heeseopark7/PROJECT4/proj4_make/TOP/5_PNR/snap/0_floorplan.png

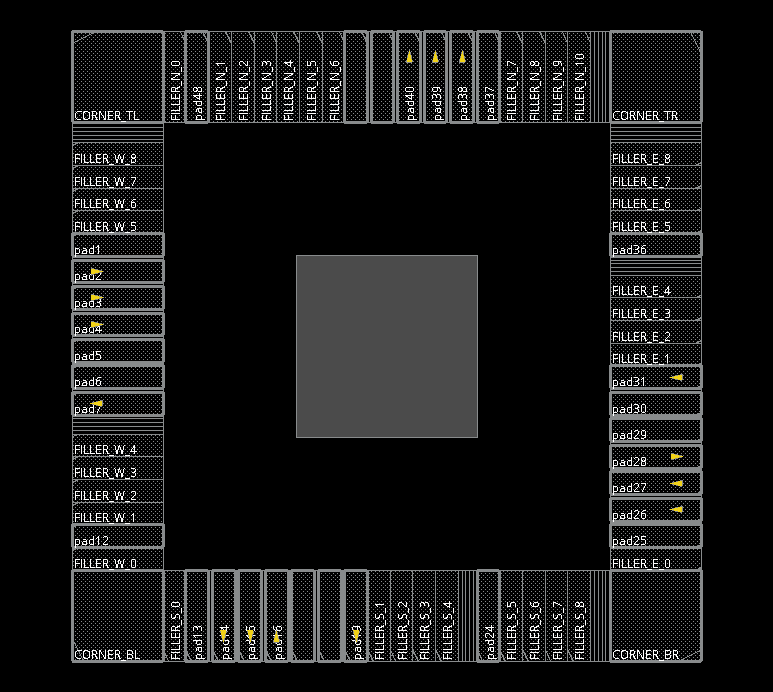
proj4_make/TOP/5_PNR/snap/0_floorplan.png
