heeseopark7/PROJECT4/proj4_make/TOP/5_PNR/result.txt

###############################################################
#  Generated by:      Cadence Innovus 22.17-s086_1
#  OS:                Linux x86_64(Host ID kopo-seongnam)
#  Generated on:      Mon Nov  9 23:03:33 2026
#  Design:            mcu_pad_top
#  Command:           checkFPlan -outFile result.txt
###############################################################
WARNING (IMPFP-7236): DIE's corner: (1370.0000000000 , 1370.0000000000) is NOT on PlacementGrid,  Please use command getFPlanMode to check current Grid settings, use command setFPlanMode to change which grid to snap to. And use command get_snap_grid_info to get grids' offset and pitch. Command floorplan can be used to fix this issue.
INFO (IMPFP-7241): Tech site CoreSite has no symmetry Y. 	Current symmetry setting : isSymmetryR90 false; isSymmetryX : false; isSymmetryY : false;

INFO (IMPFP-7244): Area Io : pad5 NOT overlapped with any rows.
INFO (IMPFP-7244): Area Io : pad6 NOT overlapped with any rows.
INFO (IMPFP-7244): Area Io : pad17 NOT overlapped with any rows.
INFO (IMPFP-7244): Area Io : pad18 NOT overlapped with any rows.
INFO (IMPFP-7244): Area Io : pad29 NOT overlapped with any rows.
INFO (IMPFP-7244): Area Io : pad30 NOT overlapped with any rows.
INFO (IMPFP-7244): Area Io : pad41 NOT overlapped with any rows.
INFO (IMPFP-7244): Area Io : pad42 NOT overlapped with any rows.
**INFO: No. of regular pre-routes not on tracks : 0
