heeseopark7/PROJECT4/(list of files, drawings)

Other design files:
proj4_make/TOP/2_SIM/FUNCTION/dump/tb_mcu_top/tb_mcu_top.dsn
proj4_make/TOP/2_SIM/FUNCTION/waves.shm/waves.dsn
proj4_make/TOP/2_SIM/POST/max/dump/tb_mcu_top_sdf_post_wst/tb_mcu_top_sdf_post_wst.dsn
proj4_make/TOP/2_SIM/PRE/dump/tb_mcu_top_sdf_gate/tb_mcu_top_sdf_gate.dsn
proj4_make/TOP/2_SIM/PRE/waves.shm/waves.dsn
