heeseopark7/PROJECT4/proj4_make/TOP/1_RTL/mcu_pad_top.v

//==============================================================================
// Module  : mcu_pad_top
// Purpose : Pad wrapper around mcu_top (chip top level). Every signal pin goes
//           through an I/O pad cell of the GPDK045 I/O library:
//             PADDI : input buffer   (.PAD = chip pin, .Y = signal to the core)
//             PADDO : output driver  (.A = signal from the core, .PAD = chip pin)
//
// Pad ring : 48 pads, 12 per side. The pad numbers follow the ring order,
//            counter-clockwise from the left side (pad names pad1 ... pad48, so
//            the SDC can use set_dont_touch on them).
//              Left   pad1  ~ pad12 : clk, clrn, UARTRXD, UARTTXD
//              Bottom pad13 ~ pad24 : SPI master  SCLK, MOSI, MISO, CSN
//              Right  pad25 ~ pad36 : SPI slave   SCLK, MOSI, MISO, CSN
//              Top    pad37 ~ pad48 : interrupts  UARTINTR, SPIINTR, SLVINTR
//            Each side, position 1..12:
//              VSSIOR | sig sig sig | VDD | VSS | sig sig sig sig sig | VDDIOR
//            That gives 8 signal slots per side (32 in total, 15 used, the rest
//            reserved for later signals). The power / ground pads are in the
//            file "add_pad" (5_PNR/add_pad). It is not part of the RTL: the
//            PnR flow appends those 16 instances to the netlist.
//
// Pads in use : 15 signal pads = clk, clrn, UART (RXD, TXD, INTR),
//               SPI master (SCLK, MOSI, MISO, CSN, INTR) and
//               SPI slave (SCLK, MOSI, MISO, CSN, INTR).
//               The 4 other UART interrupt outputs (RX, TX, RT, E) are left open
//               inside mcu_top; only the combined UARTINTR goes to a pad.
//
// Port order: peripheral pins first, clk / clrn last.
//
// Not included: corner and filler cells (PnR step).
// The debug outputs of mcu_top (pc, inst, aluout, memout) are not routed to
// pads (too many pins). The peripheral pins are the observable outputs of the
// chip, so synthesis keeps the logic that drives them.
//==============================================================================

`timescale 1ns / 1ps

module mcu_pad_top (
                    UARTRXD                             ,   // [UART]
                    UARTTXD                             ,   // [UART]
                    UARTINTR                            ,   // [UART]
                    SPISCLK                             ,   // [SPI]
                    SPIMOSI                             ,   // [SPI]
                    SPIMISO                             ,   // [SPI]
                    SPICSN                              ,   // [SPI]
                    SPIINTR                             ,   // [SPI]
                    SLVSCLK                             ,   // [SLV]
                    SLVMOSI                             ,   // [SLV]
                    SLVMISO                             ,   // [SLV]
                    SLVCSN                              ,   // [SLV]
                    SLVINTR                             ,   // [SLV]
                    clk                                 ,
                    clrn
);

//------------------------------------------------------------------------------
// External pins
//------------------------------------------------------------------------------
input               clk                                 ;   // clock
input               clrn                                ;   // reset, active-LOW
input               UARTRXD                             ;   // [UART] serial receive
output              UARTTXD                             ;   // [UART] serial transmit
output              UARTINTR                            ;   // [UART] interrupt
output              SPISCLK                             ;   // [SPI]  serial clock
output              SPIMOSI                             ;   // [SPI]  master out, slave in
input               SPIMISO                             ;   // [SPI]  master in, slave out
output              SPICSN                              ;   // [SPI]  chip select
output              SPIINTR                             ;   // [SPI]  interrupt
input               SLVSCLK                             ;   // [SLV]  serial clock from the master
input               SLVMOSI                             ;   // [SLV]  master out, slave in
output              SLVMISO                             ;   // [SLV]  master in, slave out
input               SLVCSN                              ;   // [SLV]  chip select
output              SLVINTR                             ;   // [SLV]  interrupt

//------------------------------------------------------------------------------
// Internal wires (in_ = pad to core, out_ = core to pad)
//------------------------------------------------------------------------------
wire                in_clk                              ;   // clock after the input pad
wire                in_clrn                             ;   // reset after the input pad
wire                in_UARTRXD                          ;   // [UART]
wire                out_UARTTXD                         ;   // [UART]
wire                out_UARTINTR                        ;   // [UART]
wire                out_SPISCLK                         ;   // [SPI]
wire                out_SPIMOSI                         ;   // [SPI]
wire                in_SPIMISO                          ;   // [SPI]
wire                out_SPICSN                          ;   // [SPI]
wire                out_SPIINTR                         ;   // [SPI]
wire                in_SLVSCLK                          ;   // [SLV]
wire                in_SLVMOSI                          ;   // [SLV]
wire                out_SLVMISO                         ;   // [SLV]
wire                in_SLVCSN                           ;   // [SLV]
wire                out_SLVINTR                         ;   // [SLV]

//------------------------------------------------------------------------------
// Core
//------------------------------------------------------------------------------
mcu_top     u_mcu_top   (
                .clk            (in_clk          )   ,
                .clrn           (in_clrn         )   ,
                .UARTRXD        (in_UARTRXD      )   ,   // [UART]
                .UARTTXD        (out_UARTTXD     )   ,   // [UART]
                .UARTINTR       (out_UARTINTR    )   ,   // [UART]
                .SPISCLK        (out_SPISCLK     )   ,   // [SPI]
                .SPIMOSI        (out_SPIMOSI     )   ,   // [SPI]
                .SPIMISO        (in_SPIMISO      )   ,   // [SPI]
                .SPICSN         (out_SPICSN      )   ,   // [SPI]
                .SPIINTR        (out_SPIINTR     )   ,   // [SPI]
                .SLVSCLK        (in_SLVSCLK      )   ,   // [SLV]
                .SLVMOSI        (in_SLVMOSI      )   ,   // [SLV]
                .SLVMISO        (out_SLVMISO     )   ,   // [SLV]
                .SLVCSN         (in_SLVCSN       )   ,   // [SLV]
                .SLVINTR        (out_SLVINTR     )   ,   // [SLV]
                .pc             (                )   ,   // debug, no pads
                .inst           (                )   ,
                .aluout         (                )   ,
                .memout         (                )
);

//------------------------------------------------------------------------------
// Left side (pad1 ~ pad12)
//   power pads in add_pad: pad1 VSSIOR, pad5 VDD, pad6 VSS, pad12 VDDIOR
//   signal slots: pad2 pad3 pad4 pad7 pad8 pad9 pad10 pad11 (pad8 ~ pad11 reserved)
//------------------------------------------------------------------------------
PADDI pad2  (.PAD(clk),      .Y(in_clk));            // clock
PADDI pad3  (.PAD(clrn),     .Y(in_clrn));           // reset
PADDI pad4  (.PAD(UARTRXD),  .Y(in_UARTRXD));     // [UART]
PADDO pad7  (.A(out_UARTTXD), .PAD(UARTTXD));     // [UART]

//------------------------------------------------------------------------------
// Bottom side (pad13 ~ pad24)
//   power pads in add_pad: pad13 VSSIOR, pad17 VDD, pad18 VSS, pad24 VDDIOR
//   signal slots: pad14 pad15 pad16 pad19 pad20 pad21 pad22 pad23 (pad20 ~ pad23 reserved)
//------------------------------------------------------------------------------
PADDO pad14 (.A(out_SPISCLK), .PAD(SPISCLK));     // [SPI]
PADDO pad15 (.A(out_SPIMOSI), .PAD(SPIMOSI));     // [SPI]
PADDI pad16 (.PAD(SPIMISO),  .Y(in_SPIMISO));     // [SPI]
PADDO pad19 (.A(out_SPICSN),  .PAD(SPICSN));      // [SPI]

//------------------------------------------------------------------------------
// Right side (pad25 ~ pad36)
//   power pads in add_pad: pad25 VSSIOR, pad29 VDD, pad30 VSS, pad36 VDDIOR
//   signal slots: pad26 pad27 pad28 pad31 pad32 pad33 pad34 pad35 (pad32 ~ pad35 reserved)
//------------------------------------------------------------------------------
PADDI pad26 (.PAD(SLVSCLK),  .Y(in_SLVSCLK));     // [SLV]
PADDI pad27 (.PAD(SLVMOSI),  .Y(in_SLVMOSI));     // [SLV]
PADDO pad28 (.A(out_SLVMISO), .PAD(SLVMISO));     // [SLV]
PADDI pad31 (.PAD(SLVCSN),   .Y(in_SLVCSN));      // [SLV]

//------------------------------------------------------------------------------
// Top side (pad37 ~ pad48)
//   power pads in add_pad: pad37 VSSIOR, pad41 VDD, pad42 VSS, pad48 VDDIOR
//   signal slots: pad38 pad39 pad40 pad43 pad44 pad45 pad46 pad47 (pad43 ~ pad47 reserved)
//------------------------------------------------------------------------------
PADDO pad38 (.A(out_UARTINTR), .PAD(UARTINTR));   // [UART]
PADDO pad39 (.A(out_SPIINTR),  .PAD(SPIINTR));    // [SPI]
PADDO pad40 (.A(out_SLVINTR),  .PAD(SLVINTR));    // [SLV]

endmodule
