heeseopark7/PROJECT4/(commit log)

2026-11-04 Add MCU RTL: single-cycle MIPS, APB bridge, UART, memories
    Claude-Session: https://claude.ai/code/session_01KHmRv5JscHnP1YYuwAPyRe
2026-11-04 Remove UART; simplify mcu_top; replace test program with RAM sum
    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
    [mcu_top.v]
2026-11-04 Adapt mcu_top to Extended UART ports (PADDR[11:2], PREADY/PSLVERR); update test program
    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
2026-11-04 spi deleted
2026-11-04 Add SPI master RTL (APB slave) per SPI spec v1.1
    spi_apb_top = spi_regs + sclk_gen + spi_master in 1_RTL; spi_slave
    verification model in 2_SIM.
    Claude-Session: https://claude.ai/code/session_01KHmRv53vvbxYhjS71JM31Q
2026-11-04 Integrate SPI master into mcu_top; add system sim (TB, UART stub, programs)
    - mcu_top: enable psel_spi, SPI read mux, spi_apb_top instance, SPI ports
    - 1_RTL/prog_spi.hex: loopback test program (spec 9.2)
    - 2_SIM: tb_mcu_spi, uart_ex_top stub, prog_uartdecode.hex
    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
2026-11-05 Reformat RTL to uart_ex_top style; comment out UART/SPI in mcu_top
    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
2026-11-05 Unify all RTL to the uart_ex_top coding style; update TB hierarchical paths
    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
2026-11-05 Remove fake uart_ex_top stub from 2_SIM
    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
2026-11-05 Add SPI slave APB wrapper (slot 2, commented out in mcu_top) and master<->slave loop test
    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
2026-11-05 Add 3 self-checking testbenches (mcu_top, spi master, spi slave); remove old integration TBs
    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
2026-11-05 Remove prog_mcu_top.hex (program inlined in tb_mcu_top); keep only SPI and UART hex
    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
2026-11-05 Restyle testbenches after the lab TB: clock/reset section, u_ DUT names, function_sim/SDF switches
    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
    [tb_mcu_top.v, tb_spi_master.v, tb_spi_slave.v]
2026-11-05 Pad ring: 32 pads (8 per side), renumber signal pads; add add_pad for power/ground pads
    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
2026-11-05 Pad ring: 48 pads (12 per side), reserved signal slots; update add_pad
    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
2026-11-05 Enable SPI slave (SLV) in mcu_top and connect its pads in mcu_pad_top
    Claude-Session: https://claude.ai/code/session_01KHmRv38zy5EMLonvGPe2hc
2026-11-05 Tie off SPI slave pins in tb_mcu_top and add SLV files to run_function.tcl
    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
2026-11-05 Revert "Tie off SPI slave pins in tb_mcu_top and add SLV files to run_function.tcl"
    This reverts commit 1f1cef126ebde915a254b98ae7b21b2ec168453e.
    [tb_mcu_top.v]
2026-11-05 Revert "Enable SPI slave (SLV) in mcu_top and connect its pads in mcu_pad_top"
    This reverts commit cfa7008be1ceb47aaca3e677895d59f4063fc9fd.
    [mcu_pad_top.v, mcu_top.v]
2026-11-05 Add UART sources; enable UART, SPI master and SPI slave in mcu_top and mcu_pad_top
    - add uart_ex_top, baud_gen, tx/rx fifo, tx/rx logic, reg_block, interrupt_logic
    - connect all peripheral pins to pads in mcu_pad_top
    - tie off peripheral pins in tb_mcu_top, list all sources in run_function.tcl
    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
2026-11-05 Put the test program into scinstmem as a synthesizable ROM; extend tb_mcu_top (UART loopback, SPI master<->slave, pin monitors)
    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
2026-11-05 syn prepare
    [tb_mcu_top.dsn, waves.dsn]
2026-11-06 tb_mcu_top: one testbench for RTL, pre-layout and post-layout simulation
    - DUT is mcu_top for function_sim and mcu_pad_top for sdf_gate / sdf_post_wst / sdf_post_bst
    - netlist runs end on the 8th SPI clock edge (no pc pin), RTL-only checks stay in function_sim
    - SDF annotate paths and scope for mcu_pad_top; update MCU_DESIGN.md
    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
2026-11-06 presim done
    [mcu_pad_top_delays.sdf, tb_mcu_top_sdf_gate.dsn, waves.dsn]
2026-11-07 5_PNR/init.io: pad ring for mcu_pad_top (48 slots, 31 pads, pitch 70, first offset 300)
    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
2026-11-09 2~5 stage scripts: save a GUI snapshot into snap/ after saveDesign
    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
2026-11-09 power plan
2026-11-09 power planning
2026-11-10 chip out
    [mcu_pad_top.sdf]
2026-11-10 post-layout sim
    [mcu_pad_top_post_bst.sdf, mcu_pad_top_post_wst.sdf, tb_mcu_top_sdf_post_wst.dsn, waves.dsn]
2026-11-11 post sim
    [mcu_pad_top_post_wst.sdf, tb_mcu_top_sdf_post_wst.dsn, waves.dsn]
